BleepLabs/Rad-Fi-Delay-1.5/Intro to breadboards.pdf

1 | 5 | 10 | 15 | 20 | 25

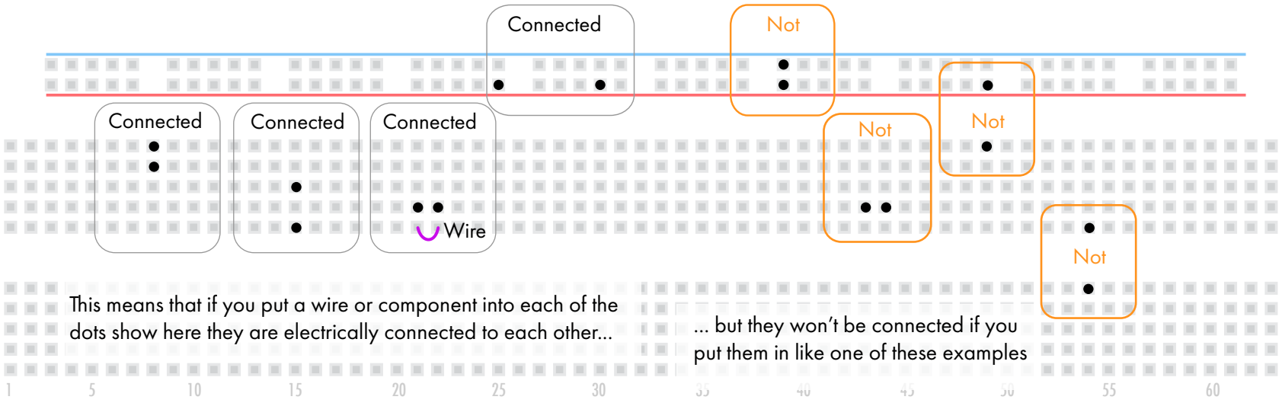
[picture p6: figure]
Wire; Connected; Not; put them in like one of these examples

This means that if you put a wire or component into each of the
dots show here they are electrically connected to each other... | ... but they won’t be connected if you

Breadboards make it easy to assemble electronic circuits without soldering

The holes on a breadboard are connected as show with the colored lines.
The vertical strips on either side of the central gap are connected in groups of five.
The horizontal red and blue “bus” lines are connected all the way across the board.

1 | 5 | 10 | 15 | 20 | 25 | 30 | 45 | 50 | 55 | 60

Wire

Wire

LED

20k Ohm Resistor

Button

9V
battery

+ -

## Your first circuit

Here we will use the button to turn the LED (Light Emitting Diode) on.

The button and resistor are non-polar meaning they can be put in either direction.

LEDs are polar, meaning they need to be installed in the circuit in the correct direction. Notice the notch on the right side of the LED. It corresponds to the notch on the LED itself. This negative “cathode” leg of the LED is shorter than the “anode” one.

When you push the button electricty can flow though the resistor to the LED.
If the resistor was not there or if it was the wrong value there might be too much power for the LED and it would burn out.

Since we are just using a 9V battery we do not need to worry about being shocked. Take care to never “short out” the battery but dirrectly connecting it’s two wires together. This will make the battery get hot and damage it.

### The same circuit can be built on the

breadboard in many different ways. | It can also be built without use of the horizonallty

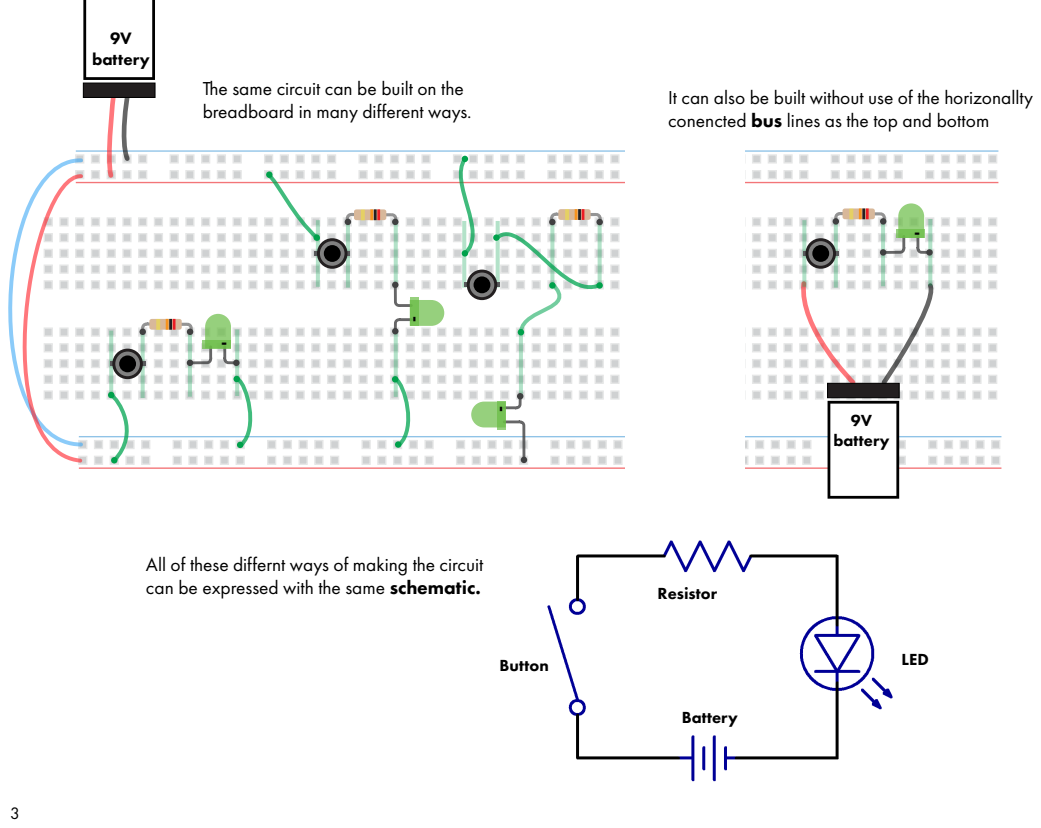
[picture p7: page 3]
9V battery; LED Button; Resistor; Battery

conencted bus lines as the top and bottom

All of these differnt ways of making the circuit
can be expressed with the same schematic.
