BleepLabs/Rad-Fi-Delay-1.5/(commit log)

2020-03-18 Delete schematic.bmp
    Missed a resistor
2020-05-20 Update rad_delay_1v5.ino
    Updated for adc.h change
